dmytyk/Arduino-Fireworks-Controller/(commit log)

2021-01-22 Reduced Size of Schematic.png
2021-01-22 Reduced Size of Schematic.png to 80%
2021-01-22 Reduced Size of Schematic.png to 75%. Made MKR 1010 Label a little clearer.
2021-01-22 Reduced size of Schematic Changed File Names Added Info to README.md
